lukeweston/CNCMachine/CNC-breakout-board-schematic.png

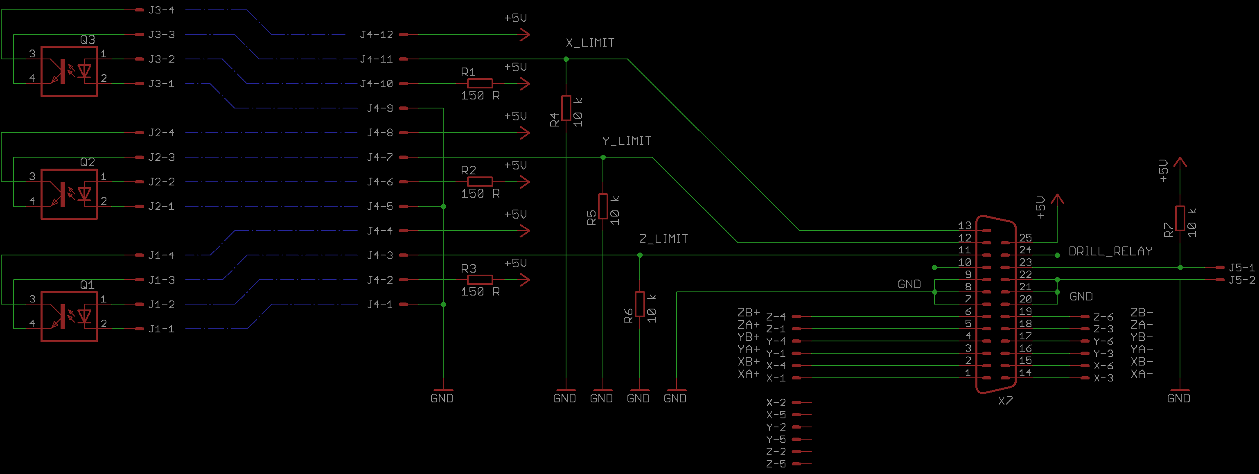
CNC-breakout-board-schematic.png
