lukeweston/CNCMachine/CNC-machine-breakout-board.png

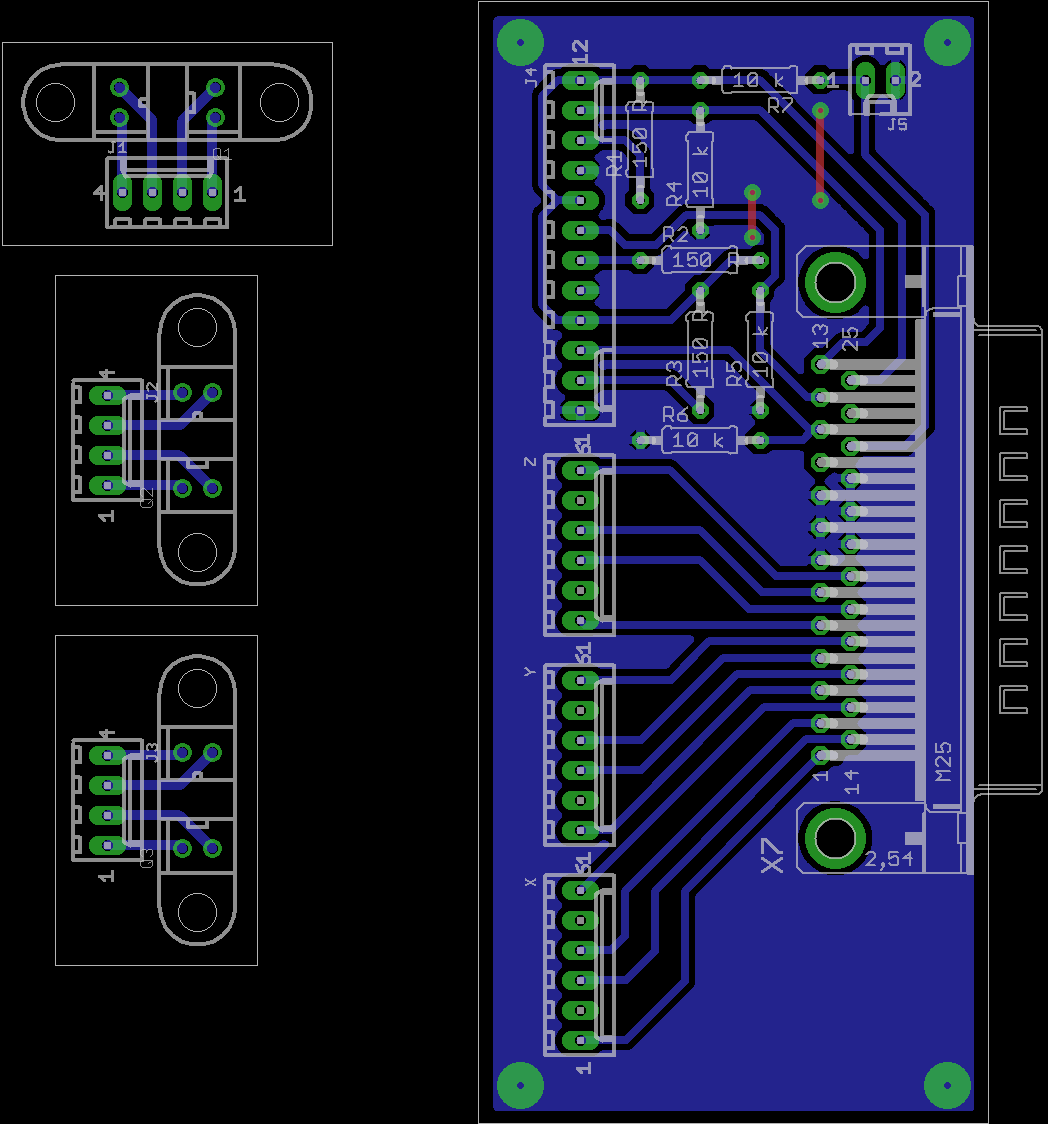
CNC-machine-breakout-board.png
