lukeweston/CNCMachine/controller-board-schematic.png

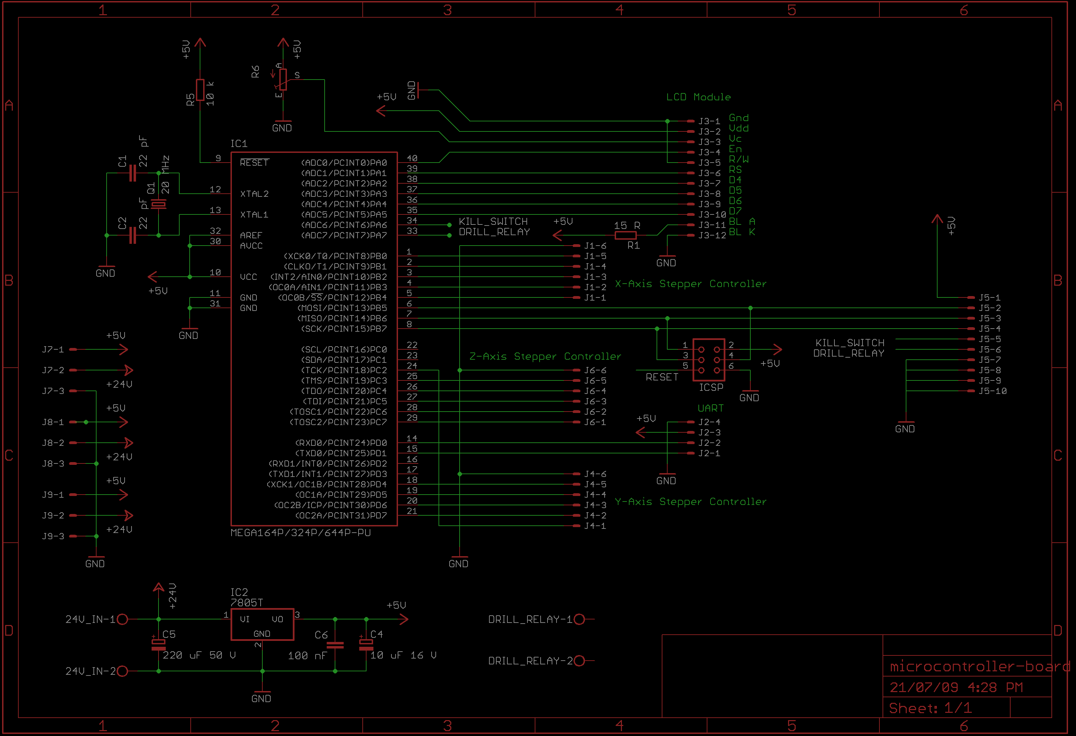
controller-board-schematic.png
