lukeweston/CNCMachine/controller-board.png

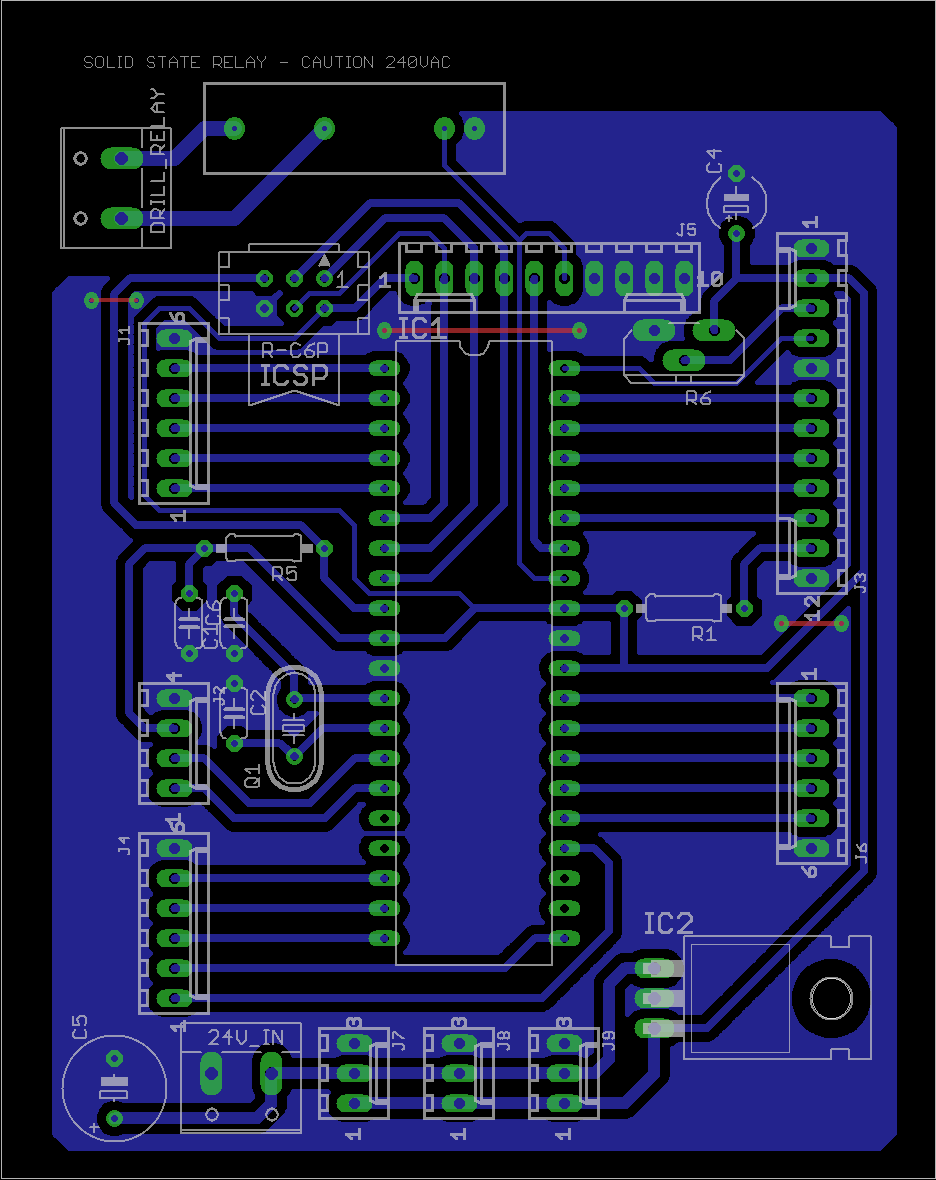
controller-board.png
