lukeweston/CNCMachine/CP2102-USB-sch.png

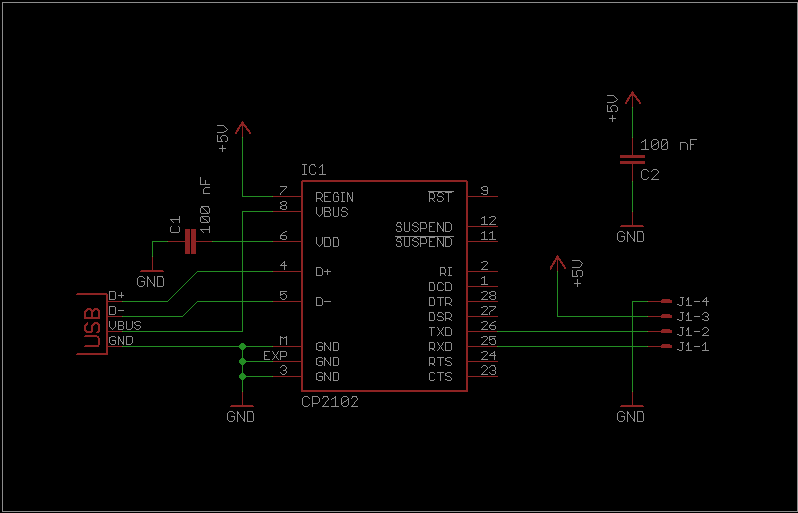
CP2102-USB-sch.png
