lukeweston/CNCMachine/D25-connector.png

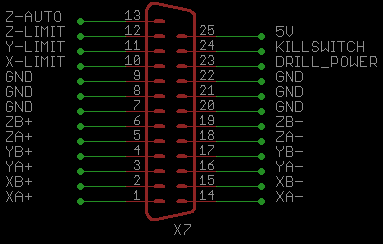
D25-connector.png
