lukeweston/CNCMachine/FTDI-board.png

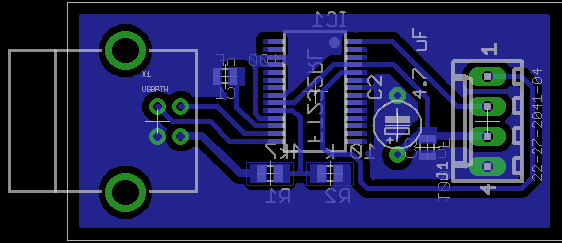
FTDI-board.png
