lukeweston/CNCMachine/FTDI-schematic.png

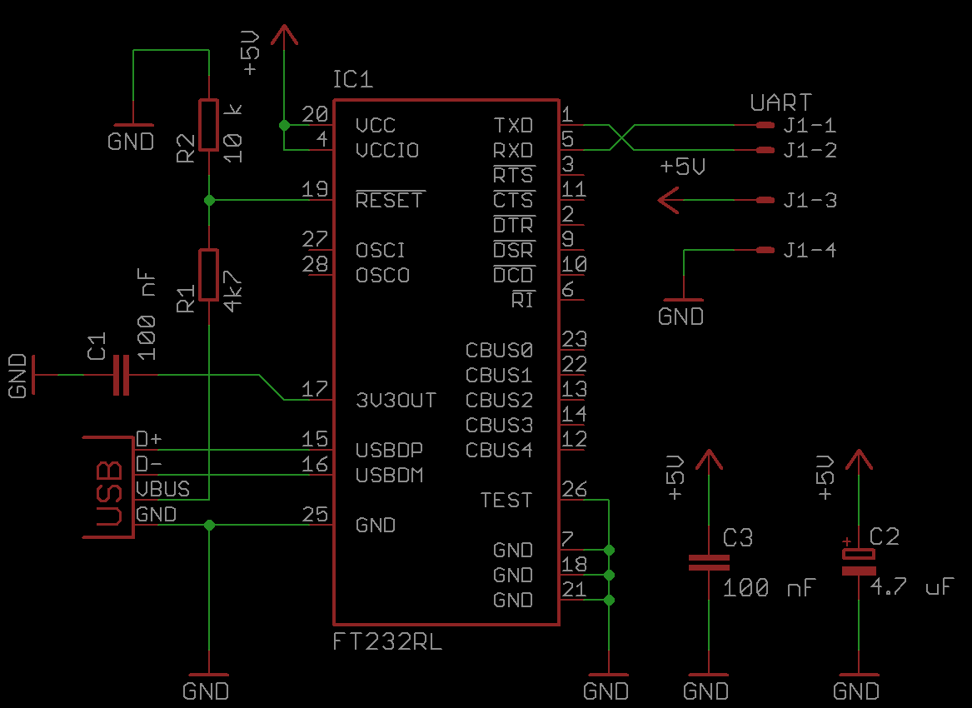
FTDI-schematic.png
