lukeweston/CNCMachine/microcontroller-board-schematic.png

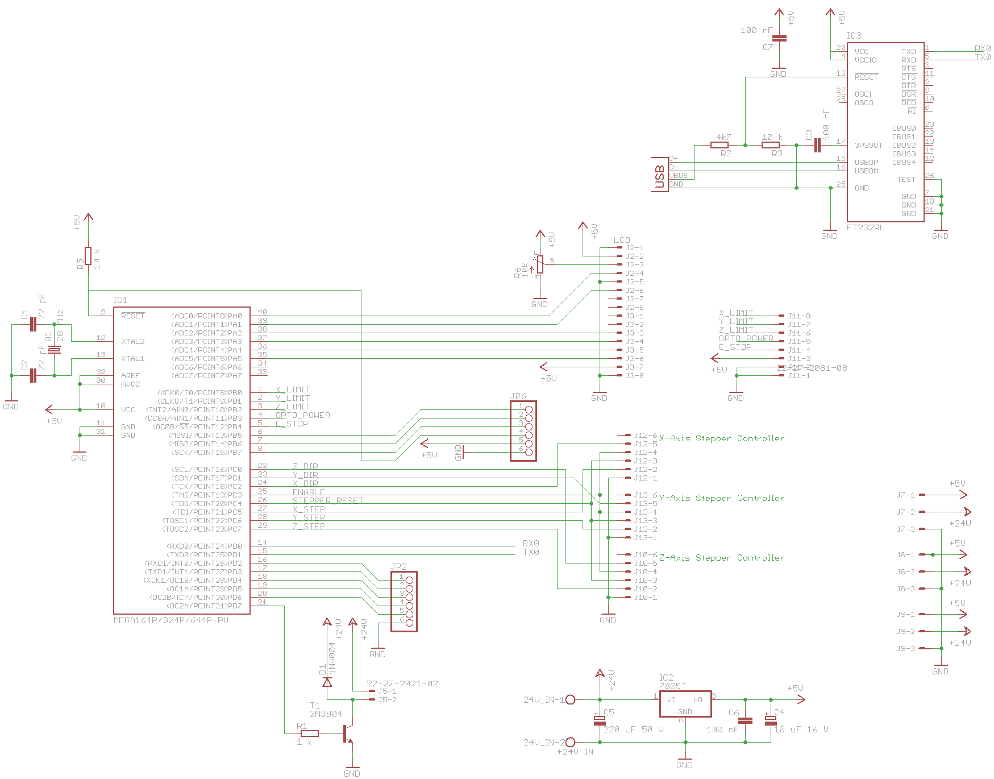
microcontroller-board-schematic.png
