lukeweston/CNCMachine/microcontroller-board.png

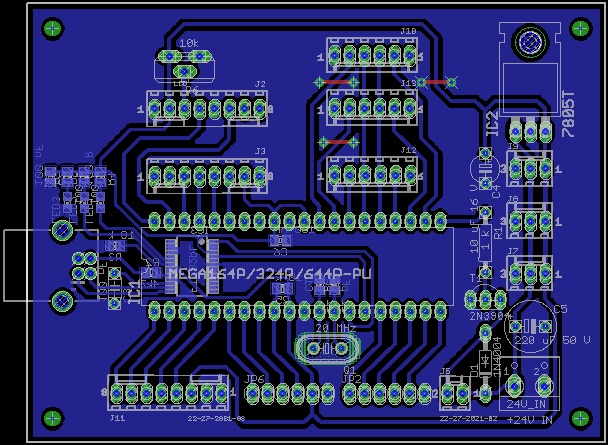
microcontroller-board.png
