lukeweston/CNCMachine/microcontroller-damien-original.png

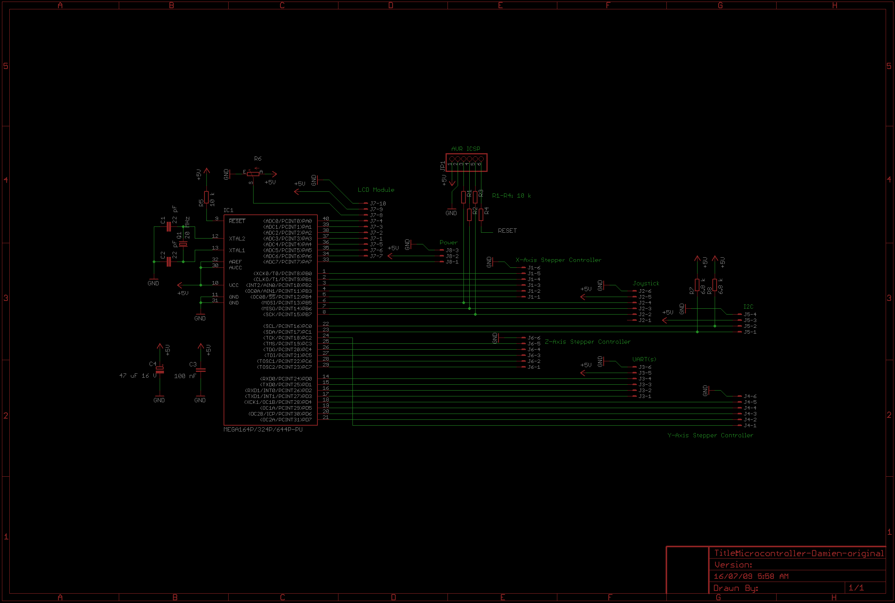
microcontroller-damien-original.png
