lukeweston/CNCMachine/microcontroller-schematic.png

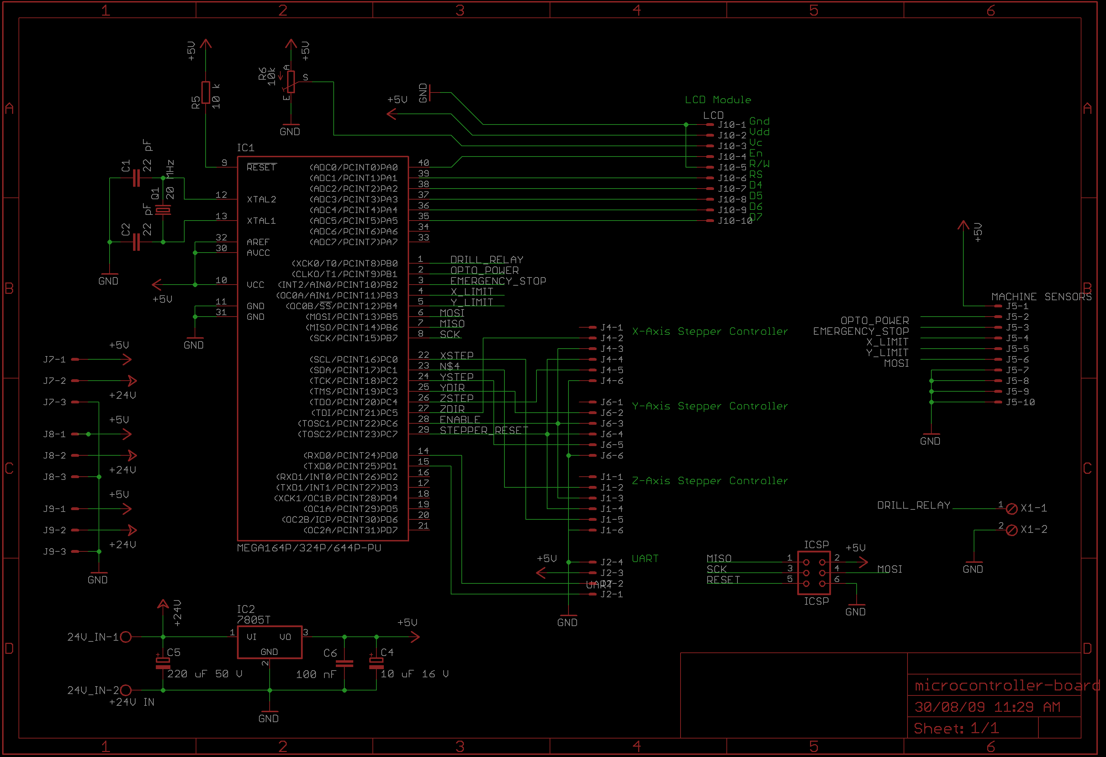
microcontroller-schematic.png
