lukeweston/CNCMachine/revised_hardware/CNC-microcontroller-board.png

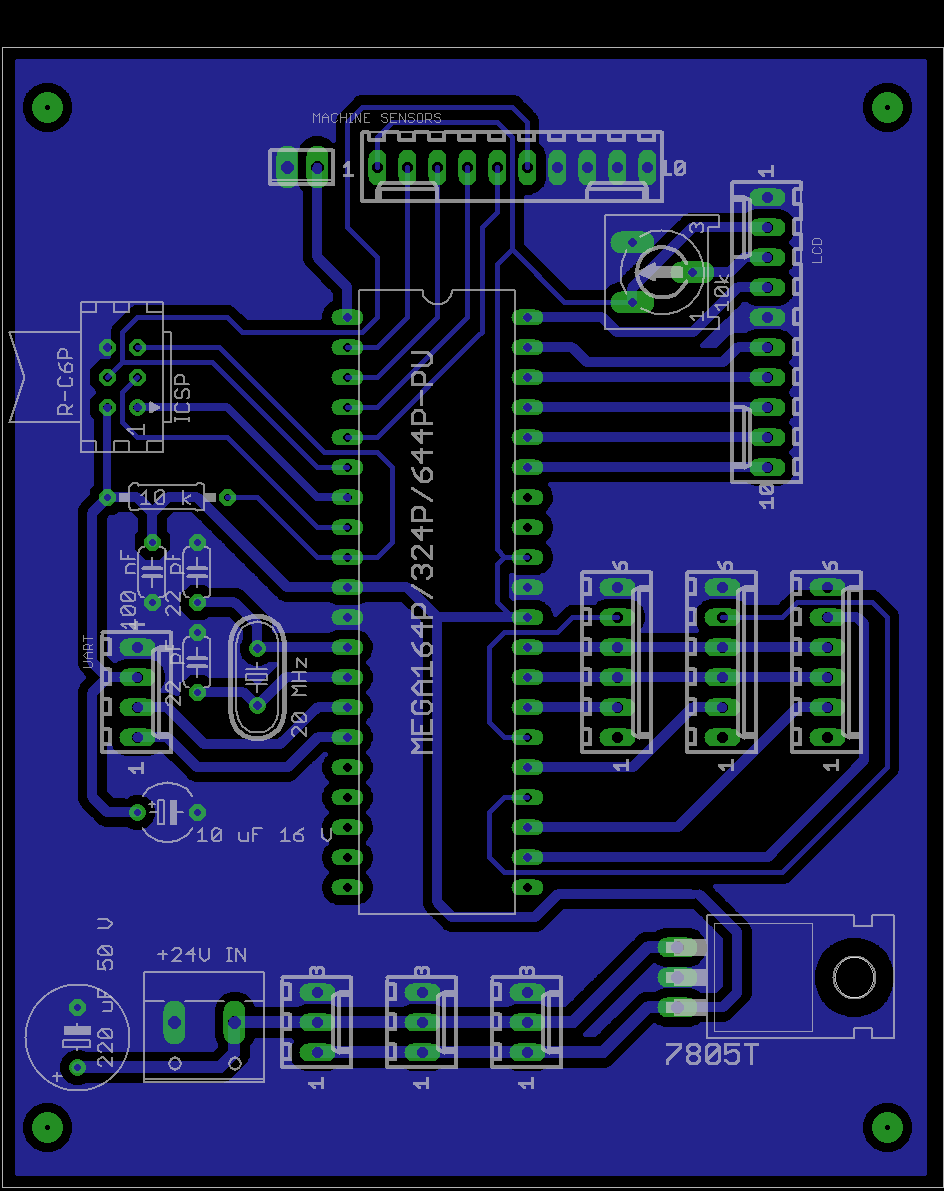
revised_hardware/CNC-microcontroller-board.png
