lukeweston/CNCMachine/revised_hardware/FTDI-board.png

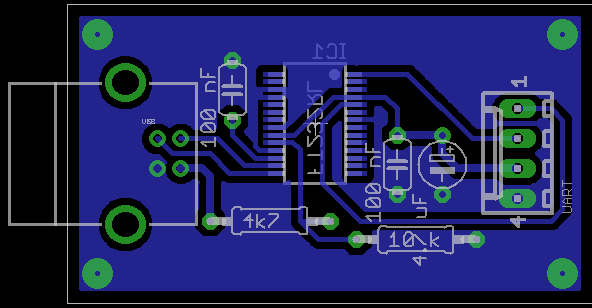
revised_hardware/FTDI-board.png
