lukeweston/CNCMachine/microcontroller-board.pdf

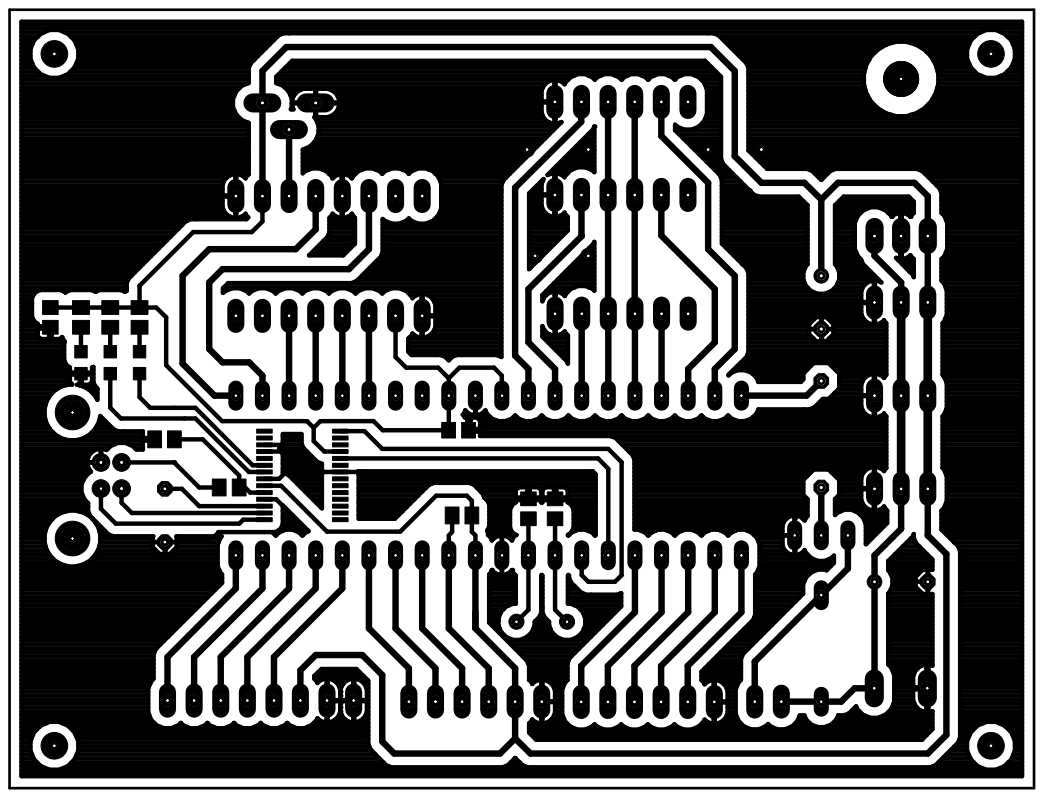
[picture p16: page 1]
