lukeweston/CNCMachine/high-level-power-wiring.png

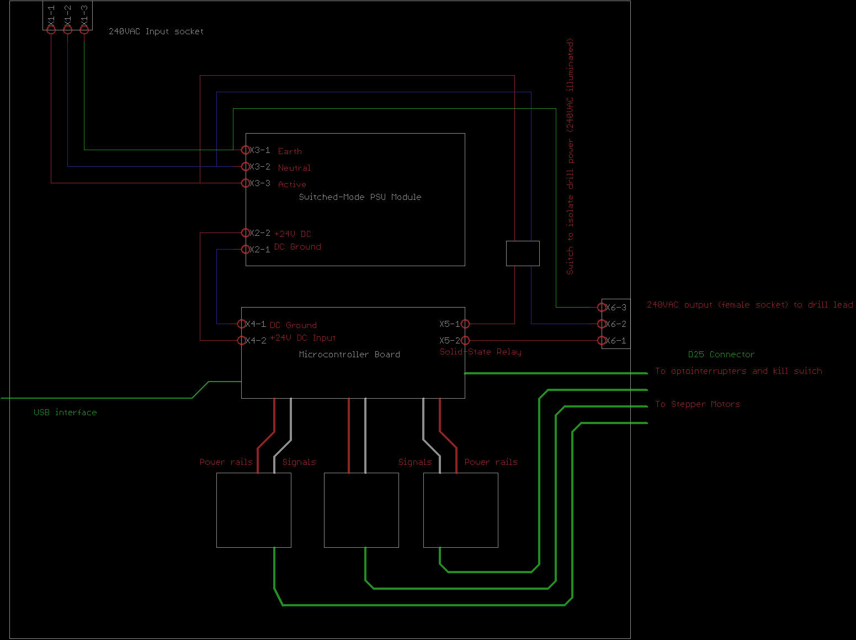
high-level-power-wiring.png
