lukeweston/CNCMachine/(commit log)

2009-08-30 revised PCB designs
    [FTDI.brd, FTDI.sch, microcontroller-board.brd, microcontroller-board.sch]
2009-11-10 Added revised board
    [microcontroller-board.brd, microcontroller-board.sch]
2009-11-11 updated current microcontroller board
    [microcontroller-board.sch]
2009-11-11 minor final tweaks
    [microcontroller-board.brd]
2009-11-12 minor finishing tweaks
    [microcontroller-board.brd, microcontroller-board.sch]
2009-11-23 added SMD indicator LEDs
    [microcontroller-board.brd, microcontroller-board.sch]
